ThomasJagielski/MADVLSI-MP4/docs/dac7.png

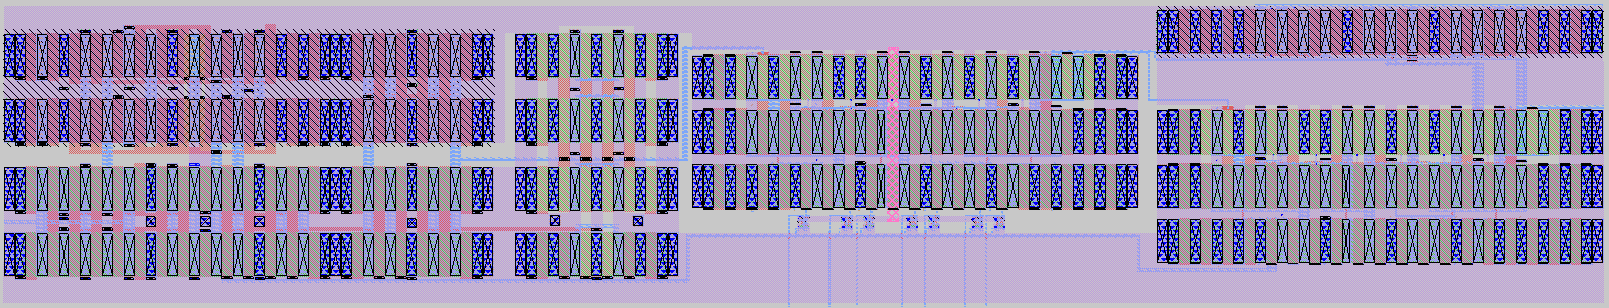
docs/dac7.png
