ThomasJagielski/MADVLSI-MP4/docs/dac7_LDS.png

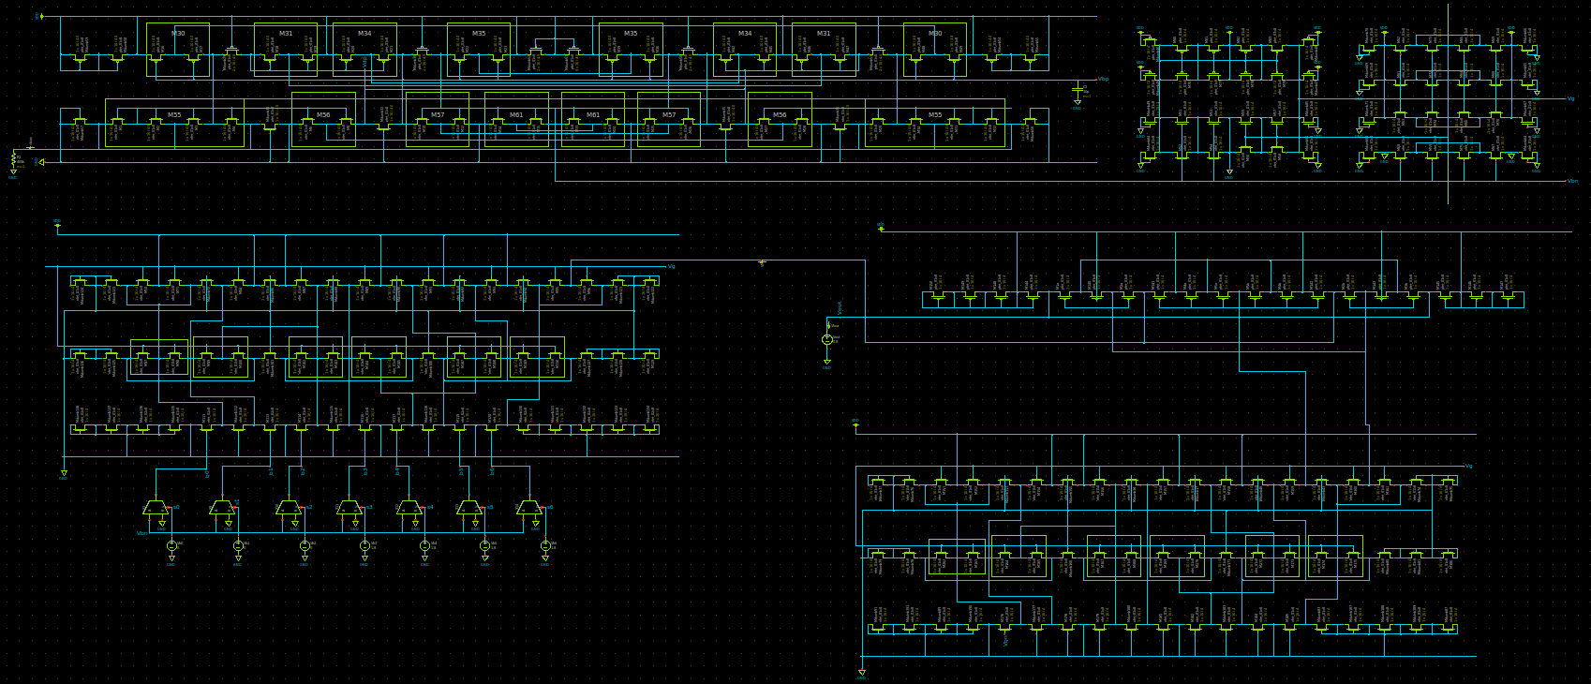
docs/dac7_LDS.png
