ThomasJagielski/MADVLSI-MP4/docs/dac7_SCH.png

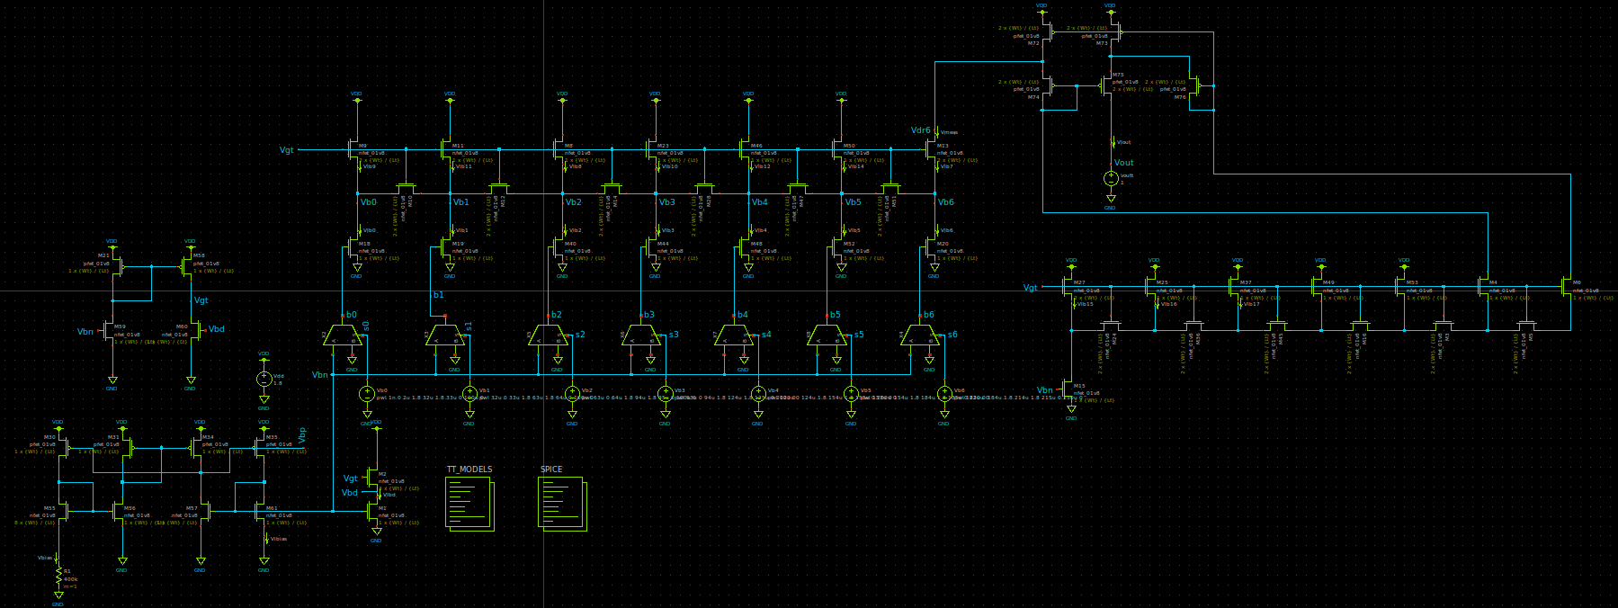
docs/dac7_SCH.png
