ThomasJagielski/MADVLSI-MP4/docs/dac_7_final-lds.png

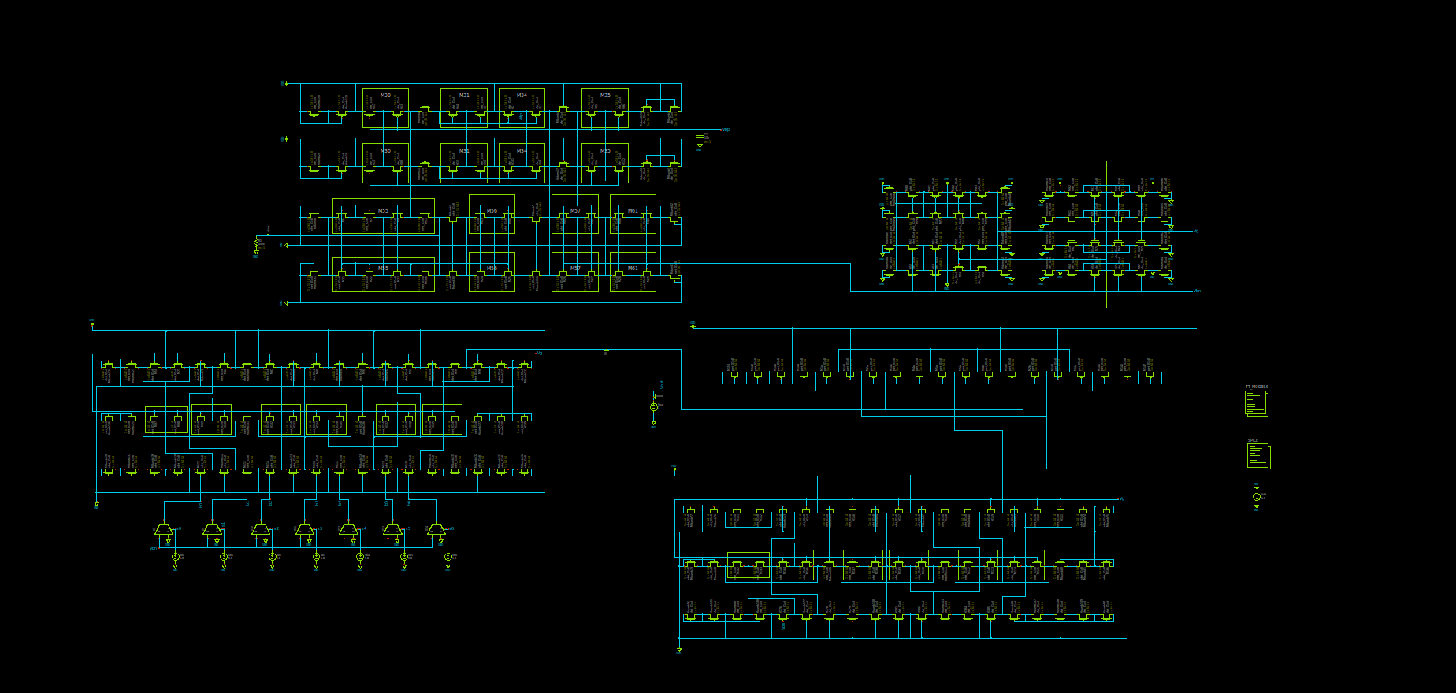
docs/dac_7_final-lds.png
