ThomasJagielski/MADVLSI-MP4/docs/dac_ladder.png

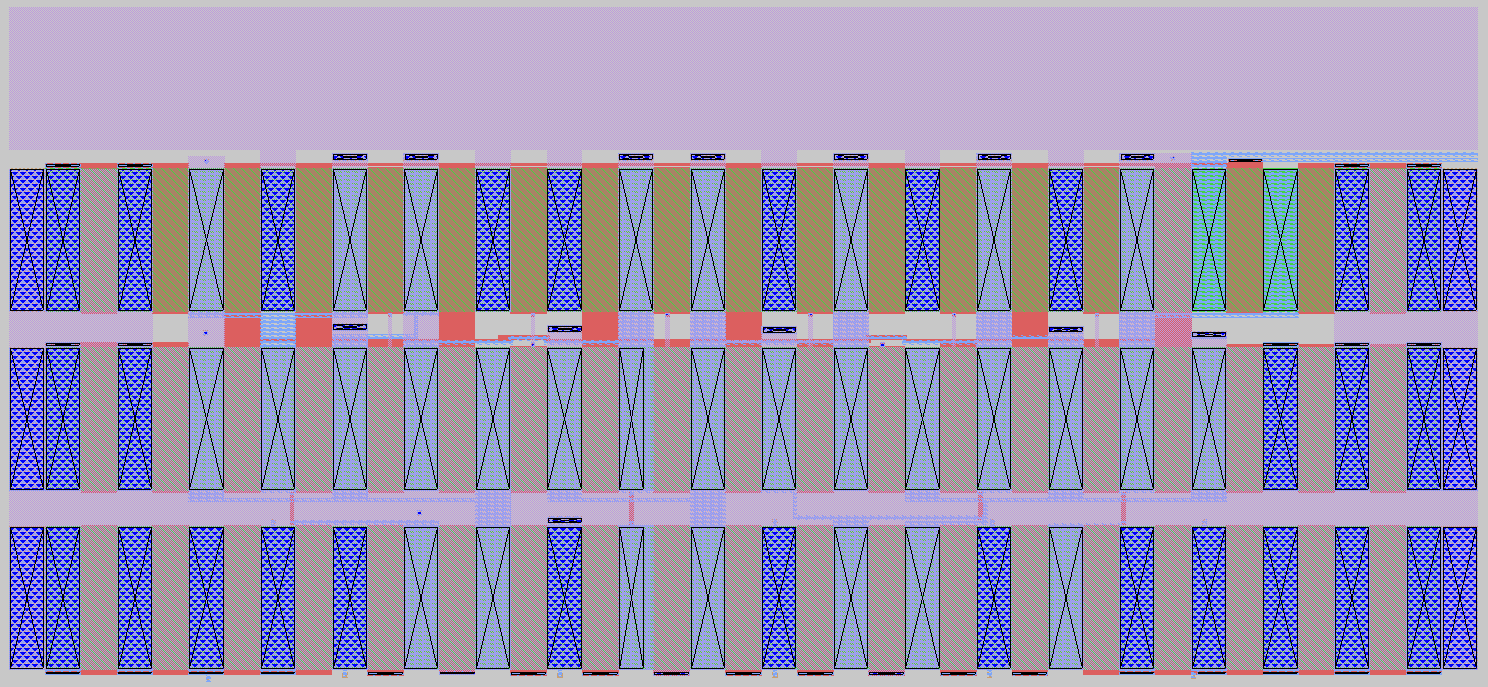
docs/dac_ladder.png
