ThomasJagielski/MADVLSI-MP4/docs/ibias_LDS.png

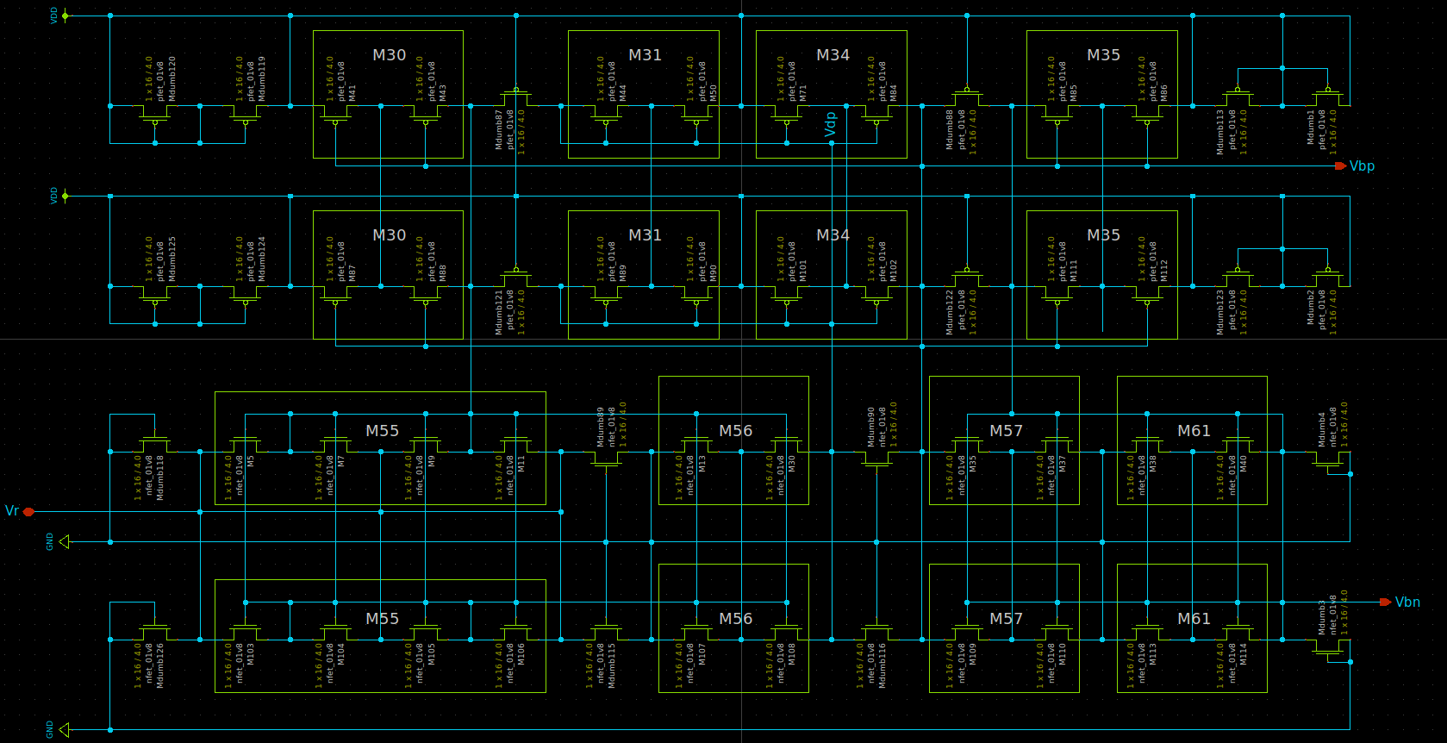
docs/ibias_LDS.png
