ThomasJagielski/MADVLSI-MP4/docs/ibias_vg-lds.png

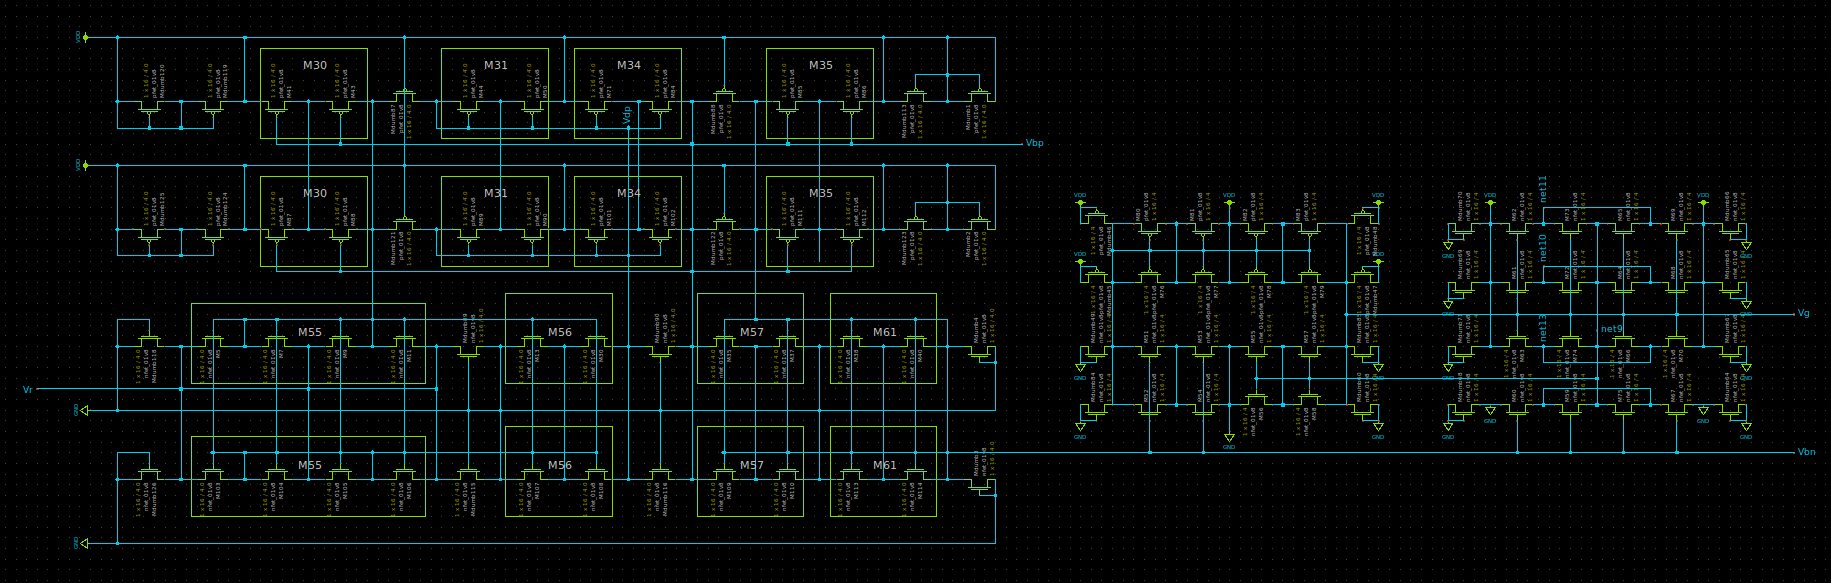
docs/ibias_vg-lds.png
