ThomasJagielski/MADVLSI-MP4/docs/ibias_vg.png

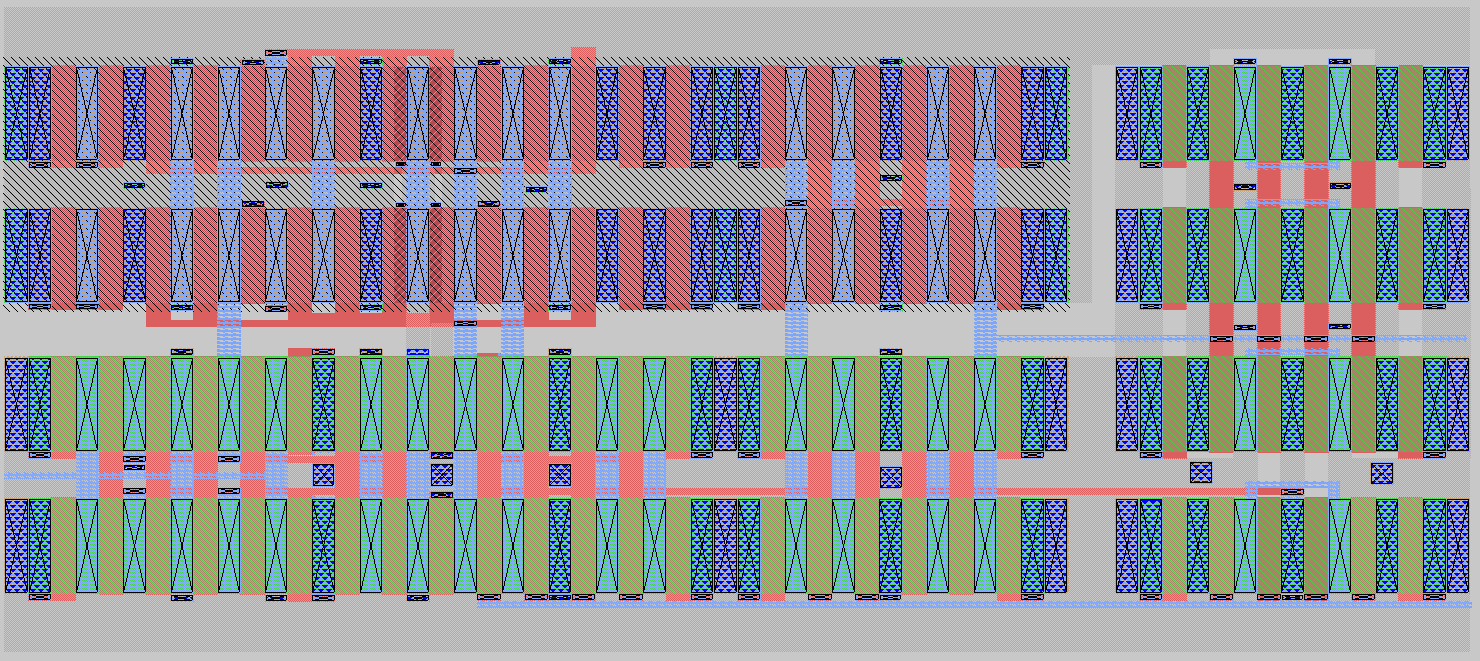
docs/ibias_vg.png
