ThomasJagielski/MADVLSI-MP4/docs/idnl_mcLDS.png

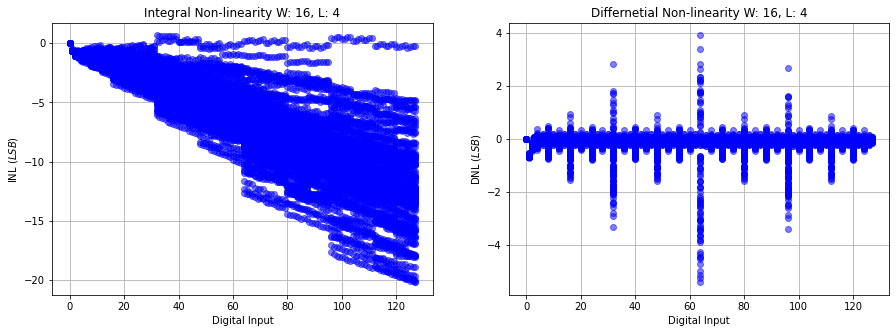
docs/idnl_mcLDS.png
