ThomasJagielski/MADVLSI-MP4/docs/idnl_mcLDSW32L8.png

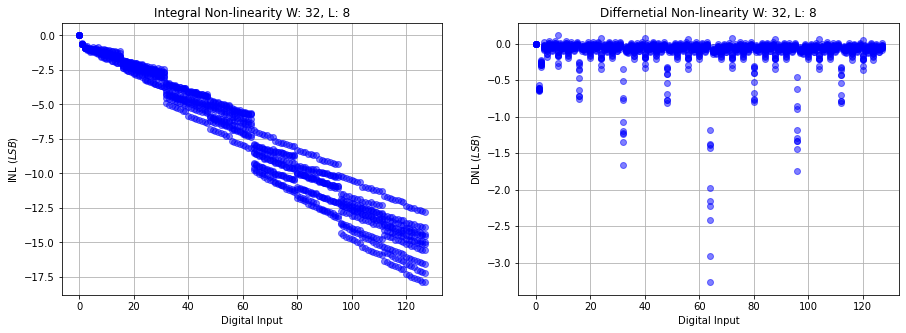
docs/idnl_mcLDSW32L8.png
