ThomasJagielski/MADVLSI-MP4/docs/idnl_mcLDSW96L24.png

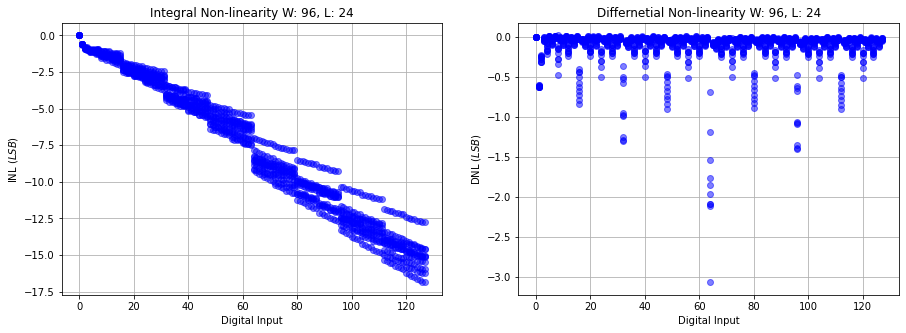
docs/idnl_mcLDSW96L24.png
