ThomasJagielski/MADVLSI-MP4/docs/idnl_nomcLDS.png

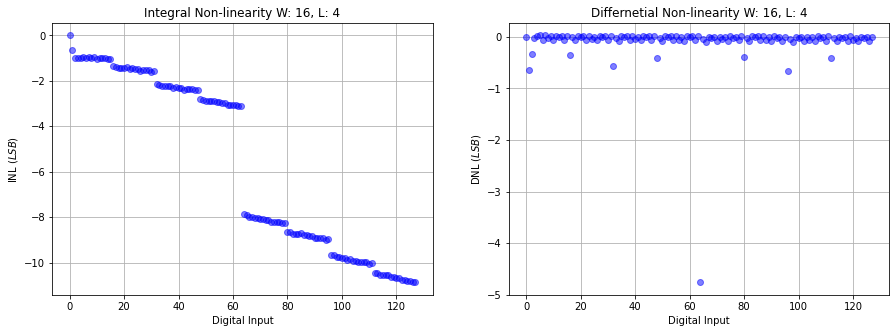
docs/idnl_nomcLDS.png
