ThomasJagielski/MADVLSI-MP4/docs/idnl_nomcog.png

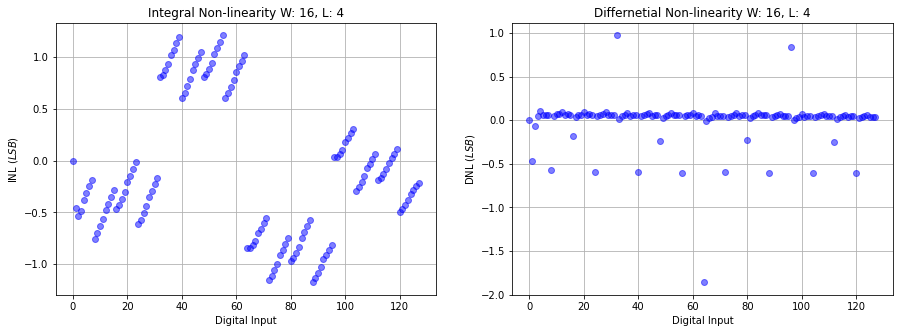
docs/idnl_nomcog.png
