ThomasJagielski/MADVLSI-MP4/docs/inverter-lds.png

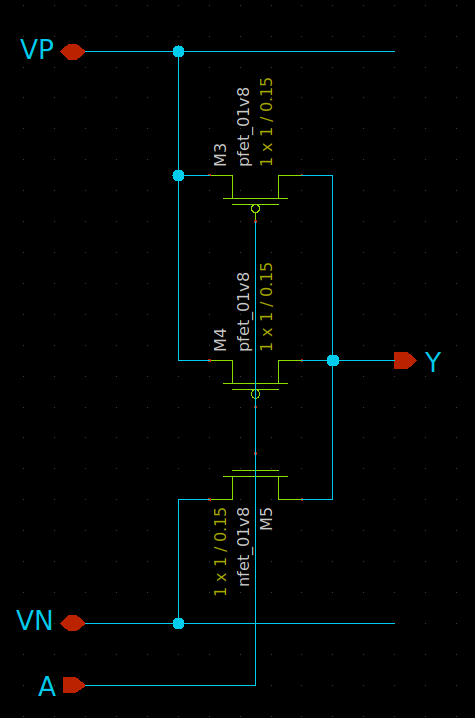
docs/inverter-lds.png
