ThomasJagielski/MADVLSI-MP4/docs/inverter_LDS.png

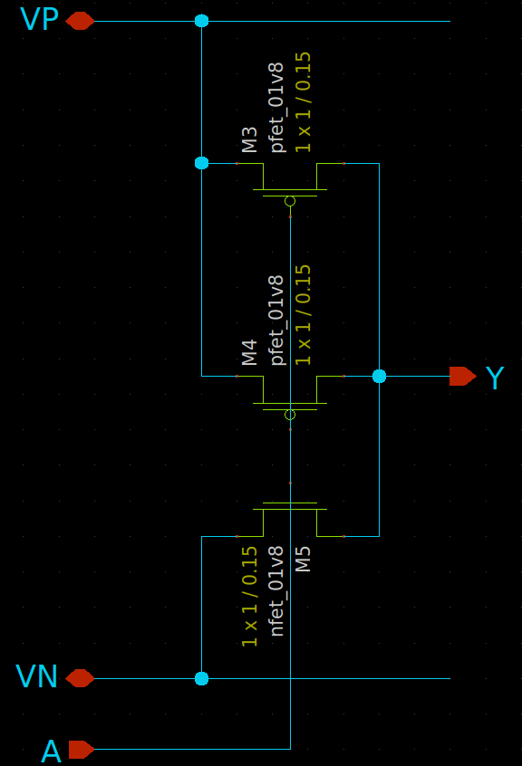
docs/inverter_LDS.png
