ThomasJagielski/MADVLSI-MP4/docs/ladder-lds.png

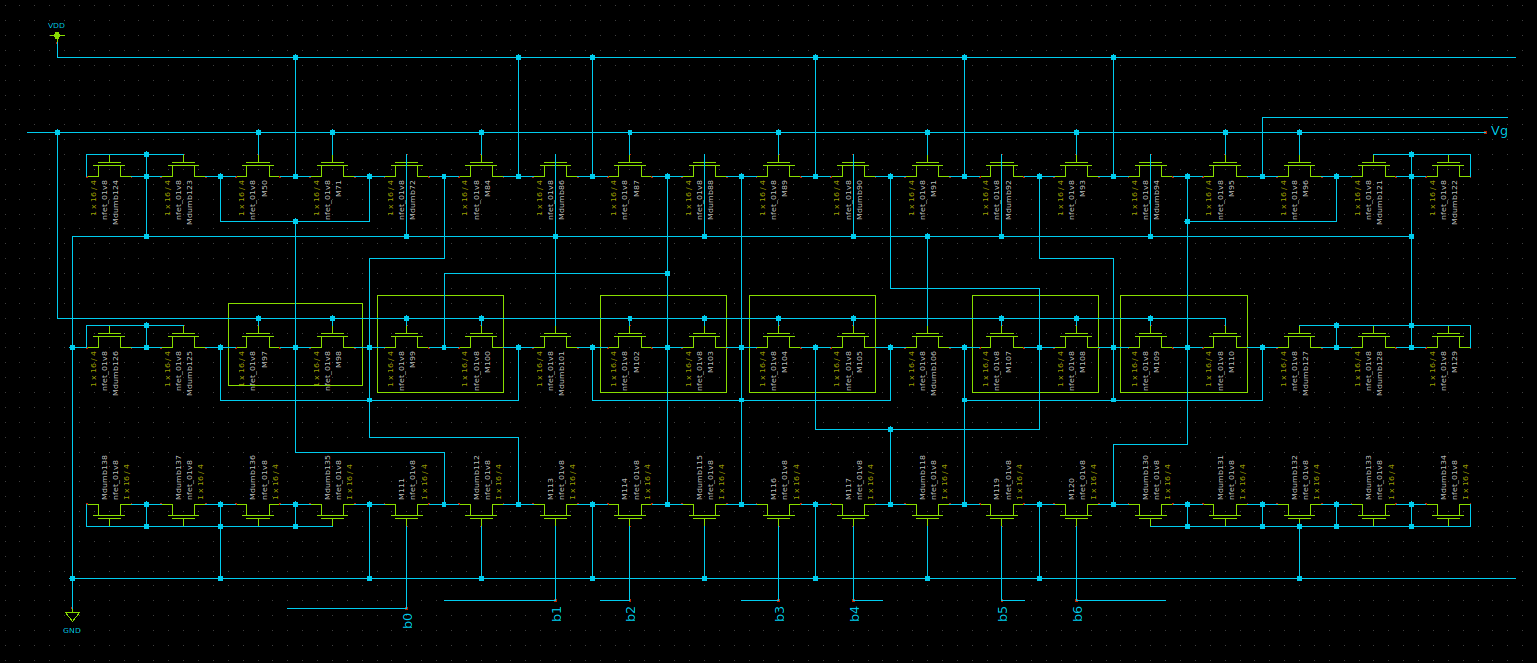
docs/ladder-lds.png
