ThomasJagielski/MADVLSI-MP4/docs/ladder_LDS.png

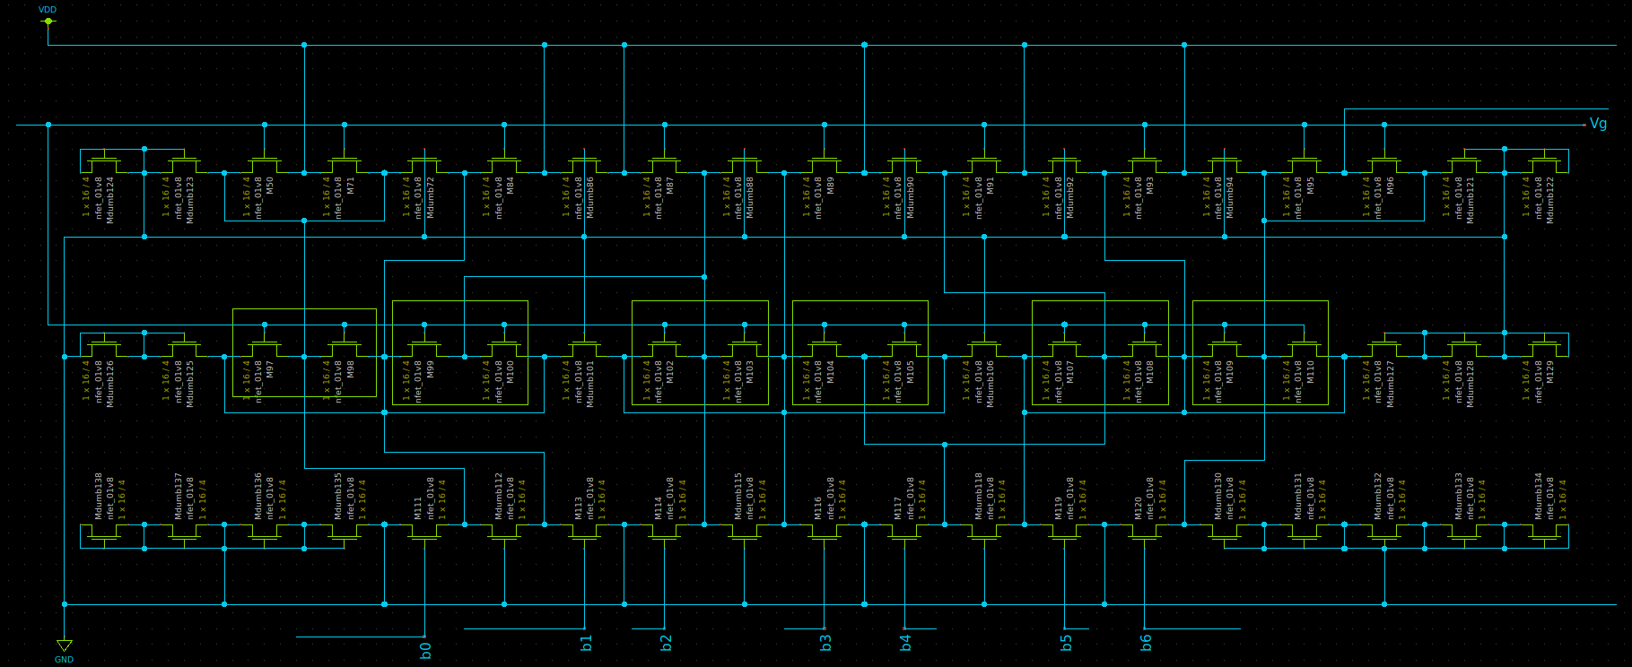
docs/ladder_LDS.png
