ThomasJagielski/MADVLSI-MP4/docs/low-voltage_super-wilson-lds.png

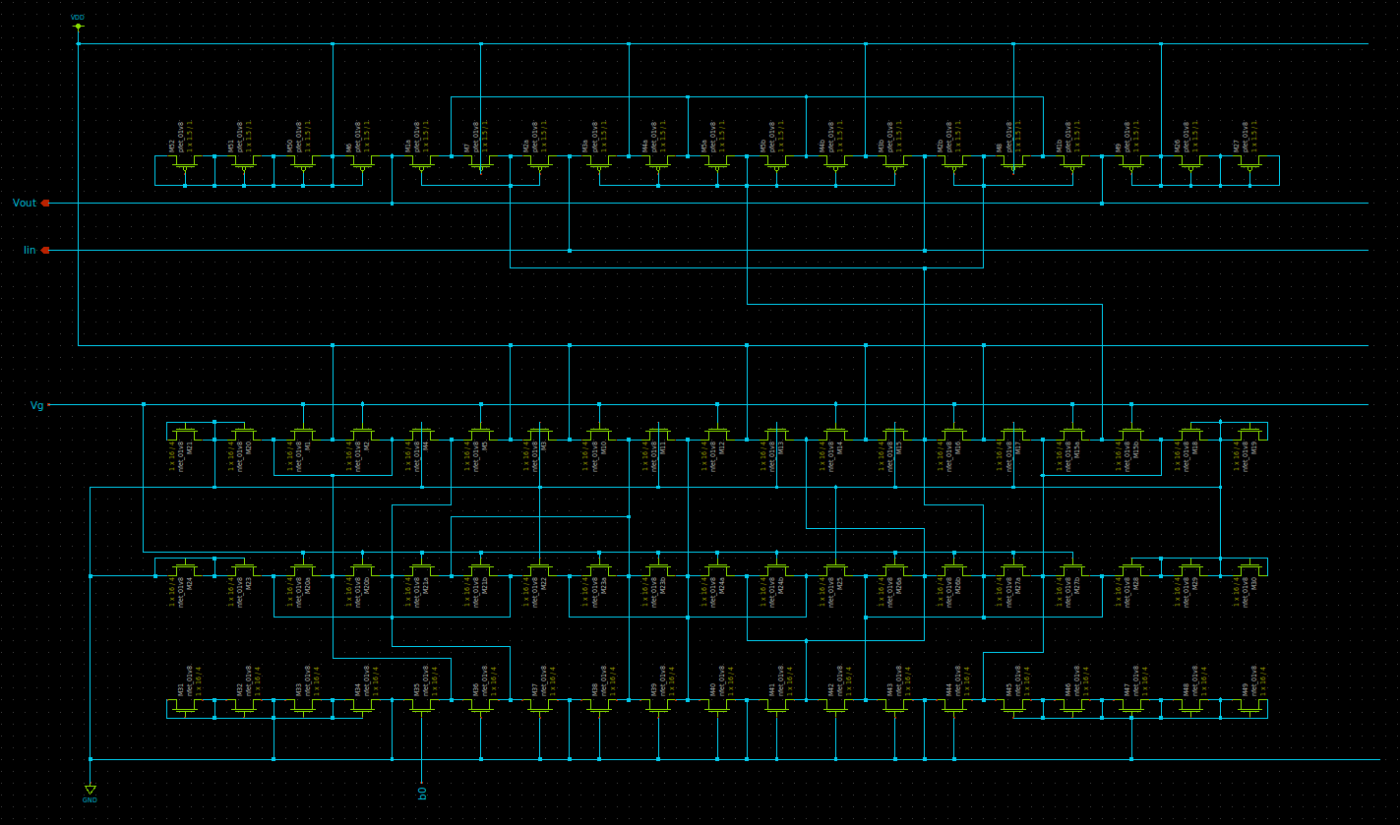
docs/low-voltage_super-wilson-lds.png
