ThomasJagielski/MADVLSI-MP4/docs/mux2-lds.png

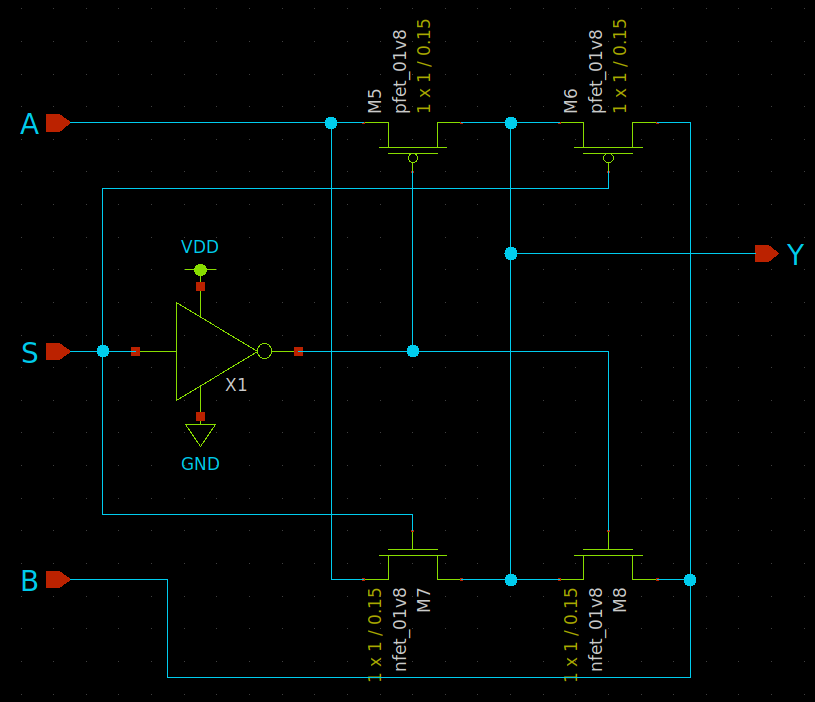
docs/mux2-lds.png
