ThomasJagielski/MADVLSI-MP4/docs/vout_sweep_2.png

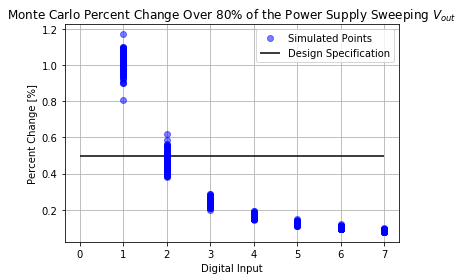
docs/vout_sweep_2.png
