ThomasJagielski/MADVLSI-MP4/docs/wilson_LDS.png

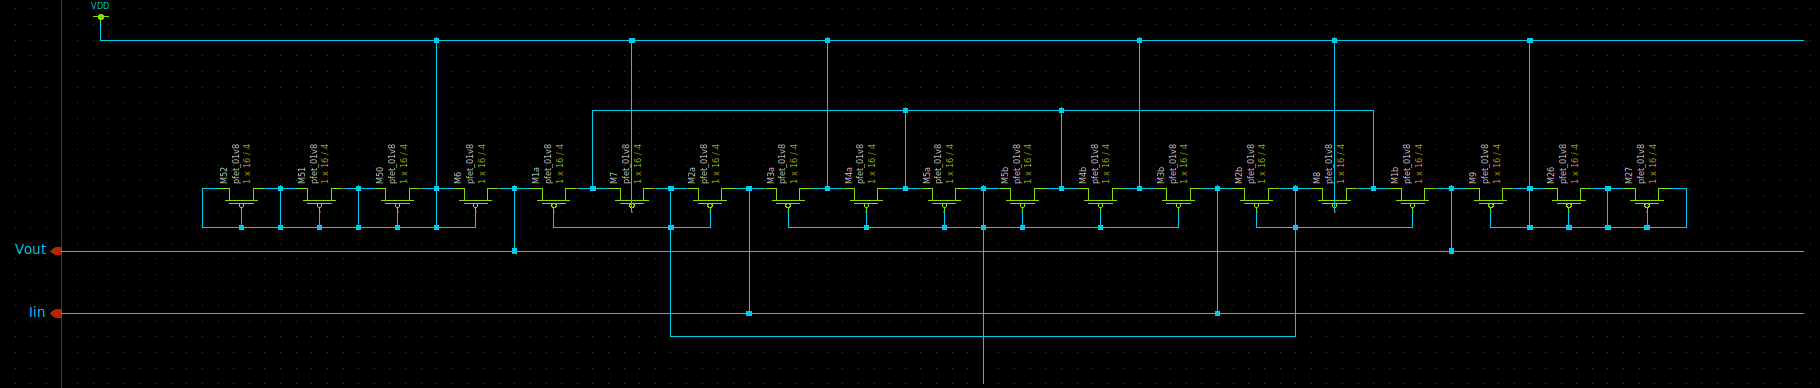
docs/wilson_LDS.png
