ThomasJagielski/MADVLSI-MP4/(commit log)

2021-03-22 Initial schematic
    [dac_converter.sch]
2021-03-23 Add circuit
    [dac_converter.sch]
2021-03-23 add bias, mux, and ladder test
    [ibias.sch, ladder3_test.sch, mux2.sch, mux2ibias_test.sch, mux2test.sch]
2021-03-23 josh playing around with cascode and diffamp
    [ladder3_test_josh.sch]
2021-03-24 dynamic sim of josh's ladder3
    [ladder3_test_josh.sch]
2021-03-24 actualy dynamic this time
    [ladder3_test_josh.sch]
2021-03-24 sample data for data processing from Brad
2021-03-24 Add 7-bit DAC
    [dac_7_bit.sch, dac_converter.sch, ladder3_test.sch, ladder3_test_thomas.sch, mux2.sch, mux2ibias_test.sch, mux2test.sch]
2021-03-24 ladder mc sim data
    [ladder3_test_josh_idnl.sch]
2021-03-25 josh's ladder3 idnl test circuit
    [ladder3_test_josh_idnl.sch]
2021-03-25 Add output stage
    [dac_7_bit.sch, ladder3_test_thomas_test.sch, ladder3_test_thomas_test_vtc.sch, low-voltage_super-wilson.sch]
2021-03-25 Add 3 bit ladder 3%/V output change design
    [ladder3_test_thomas.sch]
2021-03-26 add dynamic wilson simualtion with better Vg generation
    [ladder3_test_josh_wilson_dynamic.sch]
2021-03-26 Add layout driven shematic
    [dac_7_bit.sch, ibias.sch, inverter.sch, ladder3_test_thomas.sch, low-voltage_super-wilson.sch, mux2.sch]
2021-03-26 Add initial bias cascode LDS
    [bias_cascode.sch]
2021-03-26 Add mirrored cascode bias LDS
    [bias_cascode.sch]
2021-03-27 reproducibility check for 8, remove current mirror on output
2021-03-27 Add ladder network LDS
    [dac_7_bit.sch, dac_7_bit_LDS.sch]
2021-03-27 add circuits for sweeping DAC W/L and signup sheet
    [SL_Sweep.csv, adc7_test_SL.sch]
2021-03-27 xschem file for sweeping vdd and vout
    [adc7_test_SL.sch]
2021-03-27 more data columns for SL sweep
    [adc7_test_SL.sch]
2021-03-27 Fix transistor sizing
    [bias_cascode.sch]
2021-03-27 fix alter voltage consistency
    [adc7_test_SL.sch]
2021-03-27 Add mux layout and LVS
    [mux2.sch]
2021-03-27 Add W=6,4,1
    [adc7_test_SL.sch]
2021-03-27 Add W=3 tests
    [SL_Sweep.csv, adc7_test_SL.sch]
2021-03-27 fix the wrong number in while loop
    [adc7_test_SL.sch]
2021-03-27 Add intermediary dummy transistors to Wilson
    [low-voltage_super-wilson.sch]
2021-03-27 Add new ladder LDS
    [dac_7_bit_LDS.sch]
2021-03-27 Add labels
    [dac_7_bit_LDS.sch]
2021-03-27 Add first pass full-Wilson LDS
    [low-voltage_super-wilson.sch]
2021-03-27 going back to circuit designs : (
    [ladder3_test_josh_wilson_dynamic.sch]
2021-03-27 with Brad's recommendation
    [dac7_test_josh_wilson_dynamic.sch]
2021-03-28 W16L4 mc sim with 5 leg ladder
2021-03-28 W16L4 mc sim with 7 leg ladder
2021-03-28 W16L4 mc sim with 6 leg ladder
2021-03-28 W20L4 mc sim with 5 leg ladder
2021-03-28 W20L5 mc sim with 5 leg ladder
2021-03-28 W20L4 mc sim with 7 leg ladder
2021-03-28 W24L6 mc sim with 7 leg ladder
2021-03-28 trying cascode
    [dac7_test_josh_cascode_idnl.sch]
2021-03-28 Add simulations for cascode output
    [cells.csv, dac7_test_thomas_cascode_idnl.sch]
2021-03-28 trying diode connected again
2021-03-29 trying diode connected with vout sweep
2021-03-29 L4W16 ladder 3 and 4, and series bias, half resistor
2021-03-29 L4W16 ladder 3 and 4, and series bias, twice resistor
2021-03-29 L4W16 ladder 3 and 4, and series bias, 4x resistor
2021-03-29 L4W16 ladder 3 and 4, and series bias, 8x resistor
2021-03-29 L4W20 ladder 3 and 4, and series bias, 8x resistor
2021-03-29 L6W30 ladder 5 and 6, and series bias, 8x resistor
2021-03-29 L6W30 ladder 5 and 6, and series bias, 4x resistor
2021-03-29 most circuits so far
    [dac7_test_josh_wilson_idnl.sch]
2021-03-29 most circuits so far, 4x, ladder leg 6 and 7, no series
    [dac7_test_josh_wilson_idnl.sch]
2021-03-29 4x, ladder leg 5 and 6, series
2021-03-29 Add DAC Ladder
    [cells.csv, dac_7_bit.sch, dac_7_bit_LDS_old.sch]
2021-03-30 Vg generator LDS
    [Vg_gen_lvs.sch]
2021-03-30 Add LDS files
    [bias_cascode.sch, dac_7_bit_LDS.sch, dac_7_bit_LDS_old.sch, ibias.sch, low-voltage_super-wilson.sch]
2021-03-30 Add overall LDS
    [dac_7_final_LDS.sch]
2021-03-30 Add code blocks and models for LDS DAC
    [dac_7_final_LDS.sch]
2021-03-30 Add LDS simulation code
    [dac_7_final_LDS.sch]
2021-03-30 Add LDS simulations
    [dac_7_final_LDS.sch]
2021-03-30 Add super-wilson testbench
    [low-voltage_super-wilson-test.sch]
2021-03-30 Add test ladder
    [ladder_test.sch]
2021-04-01 test for LDS ibias vgt not working
    [ibias_vgt.sch]
2021-04-01 reference for LDS
    [dac7_test_josh_wilson_dynamic.sch]
2021-04-01 Add ladder LDS
    [ladder_test.sch]
2021-04-01 lvs for ibias vgt, ladder validation
    [ibias_vgt_oglvs.sch, ladder_test.sch]
2021-04-01 fairly good matching ladder behavior
    [ladder_ogtest.sch, ladder_test.sch]
2021-04-01 Add LDS and simulations
    [dac_7_final_LDS.sch, ibias_vgt.sch, ibias_vgt_(copy).sch, ibias_vgt_oglvs.sch, test1.sch, test1_original.sch, test2.sch]
2021-04-01 starting layout for ibias_vg
    [ibias.sch, ibias_vg_lvs.sch]
2021-04-02 Add Vout data
    [dac_7_final_LDS_dc.sch]
2021-04-02 latest dac7 op sim
    [dac_7_final_LDS.sch]
2021-04-02 Add 64x16 simulations
    [dac_7_final_LDS.sch, dac_7_final_LDS_dc.sch]
2021-04-02 Add gate-gnd connections
2021-04-02 Add initial p-tap sample
2021-04-02 Add Iref circuit updates
2021-04-03 matching LVS for ibias_vg
    [dac7_test_SL.sch, dac7_test_SL_dynamic.sch, dac7_test_josh_cascode_idnl.sch, dac7_test_josh_mywilson_idnl.sch]
2021-04-03 Add wilson layout
    [low-voltage_super-wilson_LDS_pmos.sch]
2021-04-03 Add thicker traces
2021-04-04 Add ladder schematic
    [dac_7_final_LDS.sch, ladder_lds.sch, low-voltage_super-wilson_LDS_pmos.sch]
2021-04-04 clean up hope for no merge conflicts...
    [SL_Sweep.csv, Vg_gen_lvs.sch, dac_7_bit.sch, dac_converter.sch, ibias_vg_lvs.sch, ibias_vg_oglvs.sch, ladder3_test.sch, ladder3_test_josh.sch]
2021-04-04 Add VDD sweep
    [dac_7_final_LDS_vdd.sch]
2021-04-04 LVS match for ladder
    [ladder_lds.sch]
2021-04-04 op sim for normal schematics
2021-04-05 Add new MC simulations Vout sweep
    [dac_7_final_LDS_dc.sch]
2021-04-05 Add more vout sweep simulations
    [dac_7_final_LDS_dc.sch]
2021-04-05 Add vout sweep simulations
    [dac_7_final_LDS_dc.sch]
2021-04-05 Add dc sweep files
    [dac_7_final_LDS_dc.sch, mux2.sch]
2021-04-06 schematic for LVS
    [dac_7_final_LVS.sch]
2021-04-06 Add layout
    [dac_7_final_LVS.sch, mux2.sch]
2021-04-06 lVS matches for everything
    [dac_7_final_LVS.sch]
2021-04-07 Add final netlist lvs
    [dac_7_final_LVS.sch]
2021-04-07 Add 4 layer bias circuit for lds
    [dac_7_final_LDS.sch, dac_7_final_LDS_dc.sch, dac_7_final_LDS_vdd.sch]
